Sandman6z/BalanceCar-DualFOC/README.md

# 桌面双轮平衡车

更新：2026-11-02。当前方案仅维护下面四份主文档，每个分类一个文件夹，不再使用docs/project/hardware等多层目录，也不维护多份快照、待办和决策表。

| 分类 | 主文档 | 内容 |
| --- | --- | --- |
| 整机整体 | [整机方案](整机整体/整机方案.md) | 全部选型状态、需求、运行规则和下一步工作 |
| 硬件 | [硬件方案](硬件/硬件方案.md) | STM32 BGA候选、驱动、供电、充电保护、回生、外围、接口及来源 |
| 软件 | [软件方案](软件/软件方案.md) | 双FOC、LVGL、交互、恢复逻辑、参数提案和验证 |
| 结构 | [结构方案](结构/结构方案.md) | 3D打印底座、电池/电机/板卡安装、标定与待补尺寸 |

当前：用户于2026-10-29暂定STM32G431RBI6（170 MHz、128 KB Flash、32 KB SRAM、UFBGA64），按双FOC＋精简LVGL推进；已完成最小工程链接、引脚数据库核查及GUI/数学ARM仿真；画板前仍需完善实际驱动与确认采样电气条件。其他型号保留为历史比较。电源/驱动桌面复核另发现LDO热耗散、扩展Buck低压输入、3PWM故障禁能及制动启动等问题，修改提案与未通过项见硬件方案。FUET-8530-3.6V已选；电池为3节普通平头18650，寿命不作选型要求。

2026-11-02按用户要求简化驱动保护：两DRV共用一个nFAULT输入，取消外部AND门/D触发器必选要求，保留内部保护、独立ENABLE和软件故障锁定。接线提案见硬件第11.1节；旧资源验证文件尚未更新，未完成原理图或实测。

主控、硬件电路和参数仍处于设计阶段。已有[MCU资源验证工程](软件/软件方案.md#7-验证与开发环境)，尚无完整运行固件、新版完整原理图、PCB或结构CAD，未完成样机验证。工程建议不等同用户定案，历史报价不等同实时库存/成交价。

OneDrive当前入口：`C:\Users\boe\OneDrive\平衡车`。

OneDrive的`硬件/历史资料.zip`保存整理前的全部模块化文档，以及原OneDrive项目的Word、HTML、脚本、网表和渲染物；该包仅供追溯，不作为当前接线依据。历史包只随OneDrive保存，不向GitHub重复上传旧资料；原模块化文档可从Git提交`0004bbb`及此前历史恢复。

今后直接修改对应主文档，并在该分类目录存放原理图、源码或结构文件；不再新增重复的“当前方案/最新版/快照”副本。许可证见[LICENSE](LICENSE)。
