Sandman6z/BalanceCar-DualFOC/硬件/硬件方案.md

# 硬件方案

更新：2026-11-02。所有已确认范围见[整机方案](../整机整体/整机方案.md)。本页合并原硬件选型、电源预算、接口、充电、保护、蜂鸣器和电路调查；只保留一套当前描述。工程候选未等同用户选定；原理图、PCB、完整BOM与样机验证尚未完成。

## 1. MCU与采购

当前主控依据：[G431官方手册](https://www.st.com/resource/en/datasheet/stm32g431rb.pdf)、[用户指定立创商品](https://item.szlcsc.com/778058.html)。

仅选STM32、BGA，球数不限，需同时运行双FOC、姿态/平衡、LVGL、USB和外围。用户2026-10-29暂定STM32G431RBI6：170 MHz M4F、128 KB Flash、32 KB SRAM（22 KB SRAM＋10 KB CCM）、UFBGA64、5×5 mm、0.5 mm球距。按精简LVGL推进，选择型号不代表资源验证通过；其他型号保留历史比较，GD32已排除。

| 型号 | 资源与封装 | 本轮采购记录/判断 |
| --- | --- | --- |
| G473VEH6 | 170 MHz M4F，512 KB Flash/128 KB RAM，TFBGA100、8×8 mm、0.8 mm球距 | 得捷美国页显示2088颗；1颗US$12.06、10颗US$9.385/颗；非中国含税到手价，国内低价散料未核实 |
| G491REI6 | 170 MHz M4F，512 KB/112 KB，UFBGA64、5×5 mm、0.5 mm球距 | 得捷中国页显示1613颗，含13%税1颗78.90元、10颗61.049元/颗，运费另计；IO仍需精算 |
| G474VEH6 | 170 MHz M4F，512 KB/128 KB，TFBGA100、0.8 mm；增加HRTIM | 得捷页显示库存0、补货日期未知；1颗US$11.66为缺货报价；不能由一渠道缺货推断全市场无货 |
| G431RBI6，当前暂定 | 128 KB/32 KB，UFBGA64、0.5 mm | 立创图片页24.06元起/194颗与索引25.78元起/200颗不一致，数量档未知；不据此宣称1颗价。用户2026-10-29暂定；最小链接与球位核查通过；电气与实时性能待实测 |

以上为2026-10-28获取的页面/索引记录，价格库存时点不统一，不是实时成交保证。市场聚合价和贴片专用库存不能替代可单独购买的小批散料。0.8 mm通常更利于扇出，但100球四层能否布通仍需按板厂工艺验证。

当前按G431的TIM1/TIM8与两个ADC评估双电机方案；4路电流输入须核对有效采样窗口及错峰触发。不能只看内存或定时器数量：必须完成准确BGA球位、AF复用、ADC触发、DMA、中断执行时间和Flash/RAM编译评估。容量预算统一见软件方案，不再设置“必须256 KB RAM”的排除门槛。

## 2. 电机驱动、电流采样与PCB

- DRV8323SRTAR×2，SPI、无集成系统Buck、内置CSA，左右各6颗外置N-MOS。每电机3PWM、双低侧电阻，共4个ADC输入，第三相按电流和重建。
- ENABLE上电/复位默认禁能；两颗nFAULT开漏并接，共用一个MCU故障输入。取消外部AND门和D触发器必选要求，按第11.1节简化方案停双电机；不能只将PWM拉低当全部MOS关闭，故障解除不自动恢复力矩。驱动寄存器配置/回读、CSA零偏校准是启动检查。
- 电荷泵、驱动供电/VM去耦、SDO上拉、PWM模式和未用CSA通道/LS_REF按DRV8323手册设计，不能简单把第三相所有检测节点接地。
- CSD17577Q3A×12为MOS电气候选：30 V等级、实际4.5/10 V栅压导通参数及Qg需核对；30 V是否够由最坏钳位和VDS尖峰决定，成本未证实最优。栅阻4.7 Ω仅作预留起点，IDRIVE由波形调整。
- 采样提案：每电机2×10 mΩ、1%、Kelvin/四端、2512级1 W起评估，CSA增益20。0.2 V/A；若有效双向余量假设±1 V，约±5 A测量范围，扣除零偏/摆幅/瞬态后再定；不是电机安全电流。
- 5 A情景下I²R=0.25 W，仍需脉冲与PCB热降额。未定电机不得用相电流范围代替电池/BMS电流，也不得移植航模高KV 2204参数。
- 主板优先四层、连续地参考，功率回路短、局部去耦贴桥；大电流回流不穿过CSA/ADC/IMU参考。SWD、NRST、电源与触发测试点保留。封装、EPAD、栅回路和Kelvin线按原厂要求。

## 3. 电源路径与软开关

以下是落实已定行为的功能提案，不是可直接接线图。保护芯片共口/分口、MOS方向及地关系按准确后缀完整资料落实。

```text
3S电芯 → CW1244保护输出 PACK_PROTECTED
  ├─ 核心电池锁存开关 → TPS563201 → 5V_BAT → 电源MUX
  └─ 电机背靠背开关 → VMOTOR → 双DRV8323/功率桥
                          ├─ 共用制动电阻＋低侧MOS
                          └─ 独立5V_BRAKE → 比较器/必要缓冲
USB VBUS → ESD/总输入限流/防反灌
  ├─ 电源MUX → 5V_SYS → 主板LDO/外围/ESP32扩展
  └─ IP2326 → 受保护充电端 → 电池
```

- 核心电池保持与电机运行开关分开控制，才能在USB下关运行电源而保留OLED/VCOM。USB事件本身不生成电机授权。
- TPS2113A的DRB封装为5 V级MUX候选，不接3S原电池；按实际后缀、电流、切换跌落及反灌核算。核心优先USB，电池保持已生效时拔USB转电池待机。
- 运行开关采用背靠背高侧MOS方向，开通时允许必要双向回生、关闭时隔离；启动涌流/斜率另算，不仅用Buck EN代替总开关。
- 电源键基础锁存＋MCU计时方向：按下可临时唤醒核心检测长按，未满2秒不显示用户开机、不接电机电源；松开撤销临时供电。长按成立才进入正常启动。短按用户可见行为仍为无动作。
- USB下长按关机撤销运行供电/电池保持；菜单重开运行供电同时恢复电池核心保持。MCU复位清除力矩许可，供电锁存可独立保持以显示复位原因。
- 不做8秒硬件强关，不增专用强关芯片。保留BMS及基础按键电路静态消耗，不宣称关机电流绝对为零。
- 关机先撤销力矩并禁能，再断运行电源；制动回路及控制供电始终位于电机母线同侧。USB、调试器、充电地不能旁路低侧BMS；B−/P−/C−不得随意短接。

## 4. 主板、扩展板与负载预算

主板TPS563201DDCR输出5 V，TPS562201DDCR备选，再由LDO生成3V3_MAIN。ESP32扩展板原拟用另一颗TPS563201将主板5 V降为3V3_ESP；其4.5 V输入下限在MUX/线损后缺少余量，保留降压架构但器件待重选，两路3.3 V不并联。扩展板插上随5V_SYS供电，不增加独立GPIO控制电源；其防插拔保护由用户负责，主板仍核查反灌与插入瞬态。

ME6211C33M5G-N与ME6217C33M5G均保留为待核查候选。准确商品手册缺少SOT23-5的功耗/热阻数据，不能仅凭旧家族资料300 mW排除；也不能凭标称500/800 mA宣布持续带载已通过。P≈(5−3.3)I，100/150/200/300 mA分别约0.17/0.255/0.34/0.51 W；不能用“标称500 mA”判定SOT23热能力。对应-N完整资料、稳定电容及实际PCB热阻需确认。若不够，先比较更好散热的LDO封装；改变稳压结构另列工程方案。

| 负载域 | 需要核对 |
| --- | --- |
| 3.3 V MCU | 按当前G431RBI6、频率和外设重算；旧G431的70 mA预算不能直接继承 |
| AS5047P×2 | 建议3.3 V模式，正常运行手册Max 15 mA/颗；OTP供电条件单列，不当正常负载 |
| IMU | 工作模式、3.3 V电流与中断；0.55 mA等典型条件不能当本车最大值 |
| OLED | 准确模块供电/上拉/分辨率/全亮电流；旧50 mA仅占位 |
| LED/上拉/ADC分压 | 蓝绿灯提案约1 mA/颗，按VF与亮度定阻值；其他逻辑逐项统计 |
| FUET蜂鸣器 | 若取3.3 V需计入线圈峰值、鸣叫平均电流及LDO温升 |
| 5 V | LDO输入、WS2812、OLED若取5 V、扩展Buck输入功率与损耗 |

旧166 mA/200 mA、5 V约0.878 A均为混合条件情景，不是新MCU下最坏电流。ESP32供电至少0.5 A能力的原厂建议也不是最大负载保证。Buck电感/输出电容按输入下限、饱和、负载峰值、偏压降容和纹波重算。

## 5. 充电、保护与均衡

电芯已明确普通平头18650，3S、满电12.6 V，循环寿命不作选型要求；不额外要求用户现在提供具体型号。正式限流/充放电前仍核对实际电芯，不能由外形推定安全电流。2500 mAh/节、约27 Wh若用于预算必须标占位，不显示为真实容量；三串容量mAh不相加。总压不保证弱单节状态。

IP2326标准版已定，5 V输入升压给3S充电，EN硬件默认低、MCU控制；3S配置和外围按V1.11，CON_SEL经1 kΩ接地等接法需与准确版本复核。不能混用IP2326_8V8。D+/D−用于MCU原生USB，不直接并接充电芯片DP/DM；首版不做PD/QC申请。

0.5 A电池侧是功率核算起点，不是批准的设置。12.6×0.5=6.3 W，按85%效率示例需USB约1.48 A，另加核心/扩展消耗；普通电脑500 mA输入不能许诺该充电电流。输入限流同时覆盖核心和充电分支；源能力未验证则拒绝启充并显示原因。

充电完成优先使用可靠状态输出并结合电池电压、超时和故障分类；IP2326资料终止电流200～300 mA及系统并联负载影响需实测。输入掉电、超时、过温与EN关闭均不当充满。USB核心可单独启动，但BMS欠压恢复/低电芯充电仍按实际电路处理，不宣称已经解决。

CW1244ALBS负责独立逐节保护、过流/短路/温度及被动均衡，不依赖MCU；IP2326的23/24脚仍悬空，其2S均衡不用于3S。当前公开简版资料不足以冻结准确ALBS后缀的保护MOS、采样、NTC、均衡阻值/电流、延时和恢复接线。这是原理图定稿前需补齐的资料项，不编造参数或抄其他BMS。

电池温度与功率区各留MCU NTC检测方向，BMS温度电路独立核对；10 kΩ/B3950是候选方向，不能未经分析共接两个检测输入。保留逐节测试点、配组核查、断线/短路诊断。BM3451SMDC-T28A、IP3255AAQ已排除；CN3303、BQ77915、S8254/HY2213等仅为历史对照。

## 6. 回生与过压

电机共用母线→制动电阻→低侧N-MOS→同侧功率地。TLV3012B（集成基准、推挽）为优先电气候选；TLV3201＋外部基准为对照。按实际Qg/米勒平台/源灌电流核对直驱，能力不足加缓冲，不默认LM5109。MCU仅监测，不作为硬件耗能动作依赖。

TPS70950从VMOTOR产生独立5V_BRAKE是供电候选，仅供比较器和小驱动；输入范围、散热、基准启动和回生供电建立时间都需核算。芯片可从母线取能不等于断电转轮时及时建立控制。

| 工程起点 | 值与限制 |
| --- | --- |
| 迟滞目标 | 旧13.4/13.0 V提案撤回；改评估约13.8 V导通、13.4 V释放，误差/负载边界见第11节，仍不是投板定案 |
| 制动电阻 | 用户已选定RESI TPAN0263F6R80K9，6.8 Ω±1%、50 W、TO-263，立创C38486200；13.8 V完全接通约2.03 A/28.01 W，散热与脉冲工况仍待验证，见第18节 |
| 制动MOS | 可先以CSD17577Q3A核算驱动负载，未定；需实际栅压导通与开关波形验证 |
| 母线电容 | 470 µF/35 V低ESR＋各桥局部陶瓷作为布局额度；并非已证实足够 |

电阻额定功率受安装/散热条件限制，须看脉冲能量及重复热耗散，远离电芯、IMU和塑料。TVS或母线电容不能代替持续回生耗能。按I≈V/R、P≈V²/R、E=∫Pdt、ΔV≈IΔt/C核算；控制供电上电时间须取最坏情况，不能只取比较器传播延时。

迟滞提案：VMOTOR经Rt接IN+，IN+经Rb接地、经Rf接比较器输出形成正反馈，IN−接基准。理想公式V_on=Vref(1+Rt/Rb+Rt/Rf)−VOL·Rt/Rf，V_off以VOH代替VOL；实际加入内部迟滞、误差与负载。ADC分压独立，避免采样扰动比较器门限。验证满电、BMS断开、MCU复位、控制电源异常、双电机同时回生和外力转轮。

## 7. 外围与板间接口

- AS5047P×2：SPI共享独立CS、奇偶校验，建议3.3 V模式，VDD/VDD3V3及去耦按原厂；5 V模式逻辑门限不能默认兼容3.3 V。
- ICM-42670-P：3.3 V逻辑、SPI＋INT，按原厂去耦，远离功率磁场、蜂鸣器及机械应力。
- SSD1315：0.96英寸I²C模块，LVGL驱动层适配；核查实际分辨率、引脚、供电、上拉及初始化，不直接套SSD1306模块参数。
- FUET-8530-3.6V：已选无源电磁，手册额定3.6 Vo-p、范围2.5～4.5 Vo-p、2700 Hz/50%方波条件、电流MAX 100 mA、16±3 Ω。这些不保证本车3.3 V声压或开关瞬时电流。建议3.3 V＋低侧逻辑级MOS，默认关闭、去耦/感性保护按厂家与波形验证，不接MCU直驱或5 V脉冲。表列8.5×8.5×3.0 mm与渠道高度差异需核实，焊盘不按同名8530互换。
- WS2812×4：主板5 V，SN74AHCT1G125电平转换候选，逐颗去耦/首颗串阻/OE默认态与掉电反灌核查；软件限亮不代替硬件峰值预算。
- 蓝绿0603各1：用途见软件，GPIO与阻值未冻；3.3 V蓝灯压差不足时再评估5 V开关驱动。
- Type-C：USB2.0受电设备，CC1/CC2各自5.1 kΩ、接口侧低电容ESD，VBUS总限流/反灌保护；CC下拉不等于允许取3 A。
- 扩展侧HC-PBB08-2-16-M-H1.0-G1-R-P-04已明确；主板母座候选HC-PBB08-2-16-F-H4.0-G1-R-P-04，准确配对/合高/脚号/镀层与封装待核查，不能仅将H值相加。16接点提案5 V×3、GND×5、UART×2、预留×6，按触点额定值和镜像脚号调整。UART掉电反灌/热插拔尚未验证。

## 8. 功能信号预算

| 功能 | 数量 |
| --- | ---: |
| 双电机3PWM | 6 |
| 四路相电流ADC | 4 |
| 两编码器SPI含两CS | 5 |
| 两驱动SPI含两CS | 5 |
| IMU SPI＋INT | 5 |
| OLED I²C | 2 |
| WS2812数据、蜂鸣器PWM、两普通LED | 4 |
| 母线ADC | 1 |
| K1/K2 | 2 |
| ESP32 UART | 2 |
| USB D+/D− | 2 |
| CHG_EN | 1 |
| 上述保守小计 | 39 |

另加SWD、NRST、驱动ENABLE/nFAULT、两路温度ADC、VBUS、充电状态、电源键/核心保持/运行开关、晶振与必要故障联动，39不是最终总数。IMU与驱动共享SPI可减3脚，但模式切换、开漏MISO上拉及调度必须验证。按当前G431RBI6重新画完整球位表，不使用旧G431预算宣布够用；不删调试或保护接口凑脚。

## 9. 依据与采购口径

以下保留当前方案的主要原厂/准确型号证据；完整历史调查与渠道截图线索在历史资料包及Git历史，旧报价不当实时价格。原厂典型应用/EVM/商品采用都不等同本车验证。

- [G473手册](https://www.st.com/resource/en/datasheet/stm32g473ve.pdf)、[准确型号封装](https://estore.st.com/en/stm32g473veh6-cpn.html)、[得捷报价](https://www.digikey.com/en/products/detail/stmicroelectronics/STM32G473VEH6/12337611)。
- [G491手册](https://www.st.com/resource/en/datasheet/stm32g491re.pdf)、[得捷中国报价](https://www.digikey.cn/zh/products/detail/stmicroelectronics/STM32G491REI6/13592618)、[G474得捷](https://www.digikey.com/en/products/detail/stmicroelectronics/STM32G474VEH6/10326782)。
- [DRV8323手册](https://www.ti.com/lit/ds/symlink/drv8323.pdf)、[评估板](https://www.ti.com/tool/BOOSTXL-DRV8323RS)、[ST最小系统AN5093](https://www.st.com/resource/en/application_note/an5093-getting-started-with-stm32g4-series--hardware-development-boards-stmicroelectronics.pdf)。带R版Buck/原板采样不可整套照抄。
- [MOS候选](https://www.ti.com/lit/ds/symlink/csd17577q3a.pdf)、[TPS563201](https://www.ti.com/lit/ds/symlink/tps563201.pdf)、[ME6211家族资料](https://datasheet.lcsc.com/datasheet/pdf/d15331d096a848ac81a26b001a32d4e3.pdf?productCode=C82942)。
- [TPS2113A](https://www.ti.com/lit/gpn/TPS2113A)、[TPS709](https://www.ti.com/product/TPS70950)、[TLV3012B](https://www.ti.com/lit/gpn/TLV3012B)、[TLV3201](https://www.ti.com/lit/ds/symlink/tlv3201.pdf)、[迟滞参考](https://www.ti.com/tool/CIRCUIT060078)。
- [IP2326 V1.11](https://m5stack-doc.oss-cn-shenzhen.aliyuncs.com/1132/IP2326.pdf)、[Tab5官方资料](https://docs.m5stack.com/en/core/Tab5)、[CW1244简版资料](https://uploadcdn.oneyac.com/attachments/files/brand_pdf/cellwise/11/66/Cellwise-CW1244_V1.5.pdf)。Tab5为2S参考，不证明本车3S接法；CW简版不足以冻结准确后缀外围。
- [AS5047P手册](https://www.infineon.com/assets/row/public/documents/30/49/infineon-as5047p-datasheet-en.pdf)、[ICM-42670-P资料](https://d17t6iyxenbwp1.cloudfront.net/s3fs-public/2026-05/ds-000451-icm-42670-p-datasheet.pdf)、[ESP32模组手册](https://documentation.espressif.com/esp32-s3-wroom-1_wroom-1u_datasheet_en.pdf)。
- [FUET准确型号承认书](https://atta.szlcsc.com/upload/public/pdf/source/20260910/B8B8C01008C0ED8239F313DAC3587B74.pdf)、[FUET零售入口](https://item.szlcsc.com/410561.html)、[SN74AHCT1G125](https://www.ti.com/product/SN74AHCT1G125)。
- [BTB公座图](https://www.hctldz.com/static/upload/2026/01/29/202601298345.pdf)、[BTB母座系列图](https://datasheet.lcsc.com/datasheet/pdf/1f2bc63b424e11ba595813a8850d68e5.pdf?productCode=C41421151)。

## 10. G431RBI6验证结果（2026-10-30）

结论：保留当前型号继续实现。准确UFBGA64封装的52个I/O类球位（含NRST）已按本机CubeMX官方数据库逐项检查球号、唯一性及AF/ADC可用性。51个功能IO全部使用，没有空闲；这是可行但紧凑的方案，不是完整原理图电气检查通过。

完整分配见[引脚CSV](../软件/MCU验证/pinout.csv)，自动检查见[verify.py](../软件/MCU验证/verify.py)。本轮实际采用以下安排：

| 项目 | 当前验证方向 |
| --- | --- |
| 时钟 | HSI16→PLL 170 MHz；USB采用HSI48＋CRS跟踪USB SOF；不用HSE/LSE，PF0用于电池电压ADC、PF1原作PWM_ARM_CLOCK；2026-11-02改为直接INL许可提案，见11.1 |
| 双PWM | PA8/PA9/PA10=TIM1 CH1～3；PC6/PC7/PC8=TIM8 CH1～3；中心对齐同步运行 |
| 电流 | ADC1：PA0/IN1为左A，PA2/IN3为右A；ADC2：PA1/IN2为左B，PA6/IN3为右B |
| 慢速模拟量 | PA3=运行母线、PF0=电池、PB0=电池NTC、PB2=功率NTC；不能直接接电池电压，需独立分压及保护 |
| SPI | SPI1独占两编码器；SPI3由IMU与两DRV共享，独立CS，切换模式/速率和调度仍需实现 |
| 故障 | 旧资源验证用PB12/TIM1_BKIN＋PD2/TIM8_BKIN和外部锁存提案；2026-11-02用户确定简化为两DRV共用一根nFAULT至一个MCU输入，建议保留PB12（EXTI兼TIM1_BKIN）、释放PD2。取消外部锁存，完整接线见11.1；原CSV/探针尚未随本次文档更新 |
| 启动脚 | PB8/BOOT0用于CHG_EN，必须硬件下拉保持默认禁充；I²C1改为PA15/PB9，避免BOOT0受I²C上拉影响；保留SWD，释放完整JTAG |
| 指示灯 | 蓝灯由VBUS硬件驱动，绿灯使用PB7 |
| 充电状态 | PC2改为ADC1_IN8测VBUS电压，PC3采LED状态并适配电平；BAT_STAT不再采集，它只表示涓流/恒流阶段，非充满/保护信号。充满与隐藏BMS停充仍缺少可靠区分依据，不能直接验收 |

DMA规划更新为9个通道（G431共有12个），第9个供ADC1慢速规则组含VBUS检测；见pincheck.json。电流注入组仍用中断读取，不依赖ADC DMA。通道数量核查不等同总线/中断优先级和实时调度验证。

采样计算：TIM1 ARR=4250、170 MHz中心对齐为20 kHz；TIM1 TRGO使能边沿经TIM8 ITR0启动同步，TIM1 TRGO2/OC4REF独立触发ADC。两ADC注入同时模式各2秩，先同时采左A/B、再同时采右A/B。ADC同步时钟42.5 MHz，24.5周期采样＋12.5周期转换，双秩理想耗时约1.741 µs。两PWM同相、各相占空比上限92%时，共同低侧窗口理想宽4 µs；触发在峰值前1 µs，暂按边沿稳定保护1 µs评估。上述保护时间是设计假设，须用实际MOS、驱动、CSA、分压/RC和布板波形验证；不可直接作为已证明采样有效的结论。

ADC事件周期50 µs，电流计算隔次执行为每电机10 kHz；包含双FOC的最长ADC ISR必须小于50 µs，初步目标≤30 µs。与仅按100 µs电流周期留60 µs预算的旧表述不同，不能漏掉中间一次ADC事件的期限。ADC慢速规则组、同步误差与极端占空比同样待检查。

依据：[ST RM0440](https://www.st.com/resource/en/reference_manual/rm0440-stm32g4-series-advanced-armbased-32bit-mcus-stmicroelectronics.pdf)，本机Rev 9的ADC触发章节及表267（TIM8 ITR0=TIM1 TRGO）；[G431手册](https://www.st.com/resource/en/datasheet/stm32g431rb.pdf)。本轮CubeMX手工IOC导入/生成未完整保留外设配置，未作为通过证据，也不交付该不完整IOC；以数据库逐项检查、手工HAL配置编译和明确的实测待办为依据。

## 11. 其余硬件桌面复核（2026-10-30）

本轮获取并核对驱动、MOS、Buck/MUX/LDO、比较器、编码器、IMU、ESP32、蜂鸣器及逻辑器件原厂资料。来源版本/文件SHA256见[资料索引](资料索引.json)。可复现计算与理想逻辑检查：[verify_hardware.py](verify_hardware.py)，运行`python 硬件/verify_hardware.py`，结果为[验证结果.json](验证结果.json)。本轮没有实物、正式网表或SPICE电路，以下“通过”仅限指定计算/逻辑范围。

### 11.1 双DRV共用故障输入，取消外部逻辑锁存（2026-11-02）

用户明确要求简化，首版两颗DRV8323S共用一个nFAULT输入；不再把外部AND门、D触发器、独立硬件重ARM及母线比较器列为必选。此前外部锁存方案撤回为当前实施要求，旧布尔验证仅证明旧模型，不能当简化方案已验证。

防止同一半桥上下MOS同时导通，主要依靠DRV8323的TDRIVE栅极握手、自动死区及寄生误导通抑制；仍需正确选择IDRIVE/TDRIVE、栅阻、MOS和布板，并检查VGS波形。nFAULT是故障报告，不能承诺靠一根线保证所有故障都不烧管。

接线与动作的简化基线：

| 项目 | 当前安排 |
| --- | --- |
| nFAULT | 两颗开漏输出并接为DRV_FAULT_N，一颗上拉到3V3_MAIN，共用一个MCU输入；建议PB12兼EXTI/TIM1_BKIN，AOE关闭。不把输出接到各自独立电源上拉后再并联 |
| 两颗ENABLE | 保留PB13/PB14独立控制和硬件下拉，上电/复位默认禁能 |
| 六个INH | 接原六路PWM并设下拉；配置完成前强制为低 |
| 六个INL | 提案由PF1直接作为共用INL许可控制，两组近DRV设下拉，默认低；PF1不再作触发器时钟。六输入漏电、内部下拉和总电容须核对，未验证GPIO扇出 |
| 内部保护 | 设置并回读3PWM、锁存过流模式OCP_MODE=00b及CSA参数；保留栅极故障、欠压等保护，实际门限随MOS/电机确定 |
| 故障处理 | 共用故障线触发快速中断，先拉低INL许可、强制六PWM低并撤销双ENABLE，停止两电机；随后处理诊断。SPI详细故障在驱动可通信时读取，必要时保持INL/PWM低重新唤醒读取；ENABLE复位可能清故障，不承诺保留原始全部状态 |
| 恢复 | 驱动相关故障由软件锁定，人工请求且检查通过后恢复；不因nFAULT回高自动启动。摔倒/传感器故障仍遵守原有限自动恢复规则 |

用户确认的是简化架构；PB12单输入和PF1直控INL是接线提案，不是已投板或验证通过。PD2不再需要用于第二个Break，可保留备用；BAT_STAT不因此自动恢复采集。原资源CSV、代码与验证结果保留历史版本，重新落实引脚时再更新，不宣称已有完整新固件。

必须保留的时序：DRV默认6PWM，模式配置前INH与INL均须为低；按手册唤醒并配置、回读3PWM后，才能准备PWM和拉高INL许可。正常停机/故障快速路径使INH、INL都低，遵守ENABLE休眠时序，不能仅用Break将3PWM拉低代替桥禁能。Break只作用于所接定时器，双电机关闭依靠中断操作，首版接受该软件联动方式，不宣称是独立于MCU的双桥硬件关断。

验收聚焦上电/复位不误导通、上下管VGS无危险重叠、任一DRV故障能停双电机、故障恢复不自行启动，以及停机/重新初始化正确。尚无原理图、样机或上述实测。高阻后绕组仍可能通过体二极管向母线回生，泄放保护继续单独设计。

依据：[DRV8323原厂手册](https://www.ti.com/lit/ds/symlink/drv8323.pdf)，第8.3.1.1、8.3.1.4.2、8.4.1.1节及相关保护寄存器。

### 11.2 稳压、总负载与USB

已纠正原审查结论：旧ME6211家族V14泛称SOT23功耗300 mW，但用户提供的ME6211C33M5G-N准确商品页对应V22手册，第5页300 mW/410°C/W仅列SOT23-3，缺少M5/SOT23-5条目；不能据此把M5-N直接判为不足。ME6217C33M5G商品页对应V02，第2页1 W只针对SOT89-5，也缺少SOT23-5热参数。两者标称输出电流500/800 mA均覆盖当前约300 mA工程额度，持续温升仍未证明；保留两颗候选，不因这份缺项资料直接决定改DC/DC。

本轮3.3 V工程分配为MCU100 mA、编码器30 mA、IMU5 mA、OLED50 mA、杂项15 mA、两DRV VREF合计6 mA，基础206 mA；加鸣叫平均100 mA为306 mA，LDO约0.520 W。蜂鸣器线圈最小13 Ω在3.3 V下的纯电阻峰值上界约254 mA，总瞬时分配约460 mA；这不是实际线圈波形，不能当持续平均电流。所有分配含占位值，尤其OLED、MCU和IMU不是已测最大值。

替代候选可比较TLV75733PDYDR（带散热焊盘SOT23）/TLV75733PDRVR（WSON），保持已定LDO架构。家族手册支持1 A、VIN 1.45～5.5 V；DYD/DRV的JEDEC热阻分别约92.5/100.2°C/W，不能把EVM的DYD 60.3°C/W套到普通DBV。0.520 W、环境50°C时，按100.2°C/W情景估Tj约102°C；最坏输入/输出误差、板内环境60°C及0.6 W以上热耗散会接近限值。需要焊盘/铜皮设计和实测，未以该估算冻结型号或价格。

主板TPS563201在3S→5 V的输入范围可继续；5 V原厂LC建议L=3.3～4.7 µH、有效C=20～68 µF。54.9k/10k＋0.768 V参考的标称输出约4.984 V；12.6 V、3.3 µH、580 kHz情景电感纹波约1.576 A峰峰值。按实际负载峰值和电流限制选饱和/温升能力，不以3 A输出标称选一颗仅3 A饱和的电感。

扩展板TPS563201不能直接判通过：USB端4.75 V，经MUX 1.5 A×150 mΩ及额外0.1 V线/保护压降，仅剩4.425 V，低于4.5 V推荐输入下限。保留5→3.3 V降压架构，重新比较低输入下限Buck；TPS62133的3～17 V、3 A仅作为电气对照候选，成本/采购及外围尚未冻结。

TPS2113A必须使用所评估的DRB封装，不能混用PW的1.25 A档；DRB可调到2 A，但限流误差与热态压降必须核查。例如手册RILIM=400 Ω时标称1.25 A、范围0.95～1.56 A，不能把标称值当保证输出。两路输入只接5 V级电源，禁止3S直接进入。主电池/USB切换压降、保持电容、逆灌和限流未通过台架验证。

按本轮分配、4颗WS2812各60 mA占位、ESP32 3.3 V/0.5 A及85%效率，5 V域约0.949 A；0.5 A电池充电在12.6 V另需USB约1.482 A，合计约2.432 A。若USB4.75 V、效率80%、电池充电上偏至0.55 A且ESP32按1 A情景，合计约3.253 A，连3 A源也不够。1.5 A源在核心占1 A时，只剩约0.169 A电池充电功率。不能将“5 V/3 A”当任何功能组合都可同时打开的保证。

普通电脑USB不能承诺同时带ESP32、全亮灯和充电。USB总限流要在充电与核心分支之前，MUX只限制核心支路；IP2326输入欠压环也不等于USB源授权/总电流限额。扩展板仍按用户要求直接取5V_SYS，不新增独立主控电源开关，因此必须明确扩展固件低功耗启动约定，并核查枚举前负载、插入浪涌和低能力源场景；本项仍未通过。

### 11.3 充电、保护与状态可观测性

IP2326 V1.11确认CON_SEL经1k到地选3S、VSET悬空对应12.6 V、RISET=180k对应0.5 A（电池端，手册±10%）；0.5 A仍只是起算值，需按实际电芯批准。DP/DM不接USB数据线：芯片在3S电压升高后会尝试申请7/9 V，不能让它与MCU原生USB共线；首版不使用快充协商，具体未用引脚接法仍需核对。

NTC与状态必须单独处理：资料示例100k/B4100并82k属于特定保护窗口，文中约45°C减流、55°C停充；不能把它当任意18650都合适，也不能把通用10k NTC直接代入。MCU/BMS/充电芯片的独立激励不能共接一个NTC节点；按实际电芯允许温度重新设计硬件窗口，MCU暂定10～40°C不能替代硬件窗口验证。

LED亮/灭/闪可描述充电、停止和异常；BAT_STAT仅描述涓流/恒流，本轮不再采集。没有可靠BMS状态时，LED灭＋总压正常仍不能严格证明正常充满：保护MOS断开、弱单节先过压或负载断开可能造成歧义。未补可信的BMS状态/单节观察或等效判据前，界面应显示“充电已停止/原因待确认”，不把所有停充显示成“已充满”；整机“正常充满可正确显示”验收项仍未通过。

CW1244公开V1.5只有简版功能/框图：ALBS可解析为A功能版本、L锂离子、B参数型、S封装型，但B型准确阈值/延迟和完整接线没有得到证明。不得用家族阈值范围代替B型配置，不得抄其他后缀补齐外围。三串均衡、过温/断线、保护MOS与恢复路径继续作为定稿阻塞项；IP2326的23/24脚仍不作3S均衡使用。

### 11.4 驱动、采样与共用SPI

10 mΩ×20=0.2 V/A可继续作为测量提案；5 A时每个电阻0.25 W。CSA增益约±3%、分流电阻±1%叠加约±4.03%，4 mV输入零偏折算0.4 A，必须校准，电流正负号也需按接线核对。DRV手册增益20、0.5 V阶跃到±1%的600 ns是条件/典型值，不是包括MOS换向、RC和ADC采样的总最坏时间；另加100 Ω/1 nF滤波本身到1%就约0.461 µs。因此第10节的1 µs边沿保护只是待实测假设，不能用“600 ns<1 µs”宣告4 µs窗口已保证。

特别纠正：SEN_LVL最低0.25 V在SP输入上的保护，10 mΩ对应25 A；默认1 V约100 A，均与CSA增益20无关。它不是5 A保护。VDS保护随MOS导通电阻、温度和门限误差变化，也不能直接当精确5 A。实际电机/电芯未知前，保留软件限流、内部锁存过流保护与软件故障锁定、VDS/VSENSE保护，并补充可验证的过流门限与响应设计，禁止以测量范围代替保护阈值。

CSD17577Q3A手册10 V栅压RDS(on)最大约4.8 mΩ、4.5 V约6.4 mΩ，Qg(10 V)最大约35 nC；3颗高侧20 kHz的平均栅电荷电流约2.1 mA，低于DRV所列25 mA平均高侧能力，但仍需看低电池电压、温度、死区和IDRIVE。栅阻4.7 Ω不是最终值；30 V VDS尖峰及热设计未通过，35 A封装标称不能当本车相电流。

编码器SPI1保持Mode 1、170MHz/32=5.3125 MHz；AS5047P上限10 MHz，CS建立与帧间高电平均至少350 ns。两片按读命令＋后续返回帧估64时钟，加4段350 ns约13.45 µs，属于通信时长估算而非总控制执行时间；需处理流水返回、奇偶和ERRFL。

SPI3的DRV采用Mode 1并降到/128=1.328125 MHz，SDO先按2.2k上拉、50 pF总线电容情景，升至0.7VDD约132 ns；再加30 ns数据延迟及20 ns采样裕量，小于半周期376 ns。电容、IMU下拉驱动能力及实际波形仍需核查。IMU默认支持Mode 0/3，可先按默认模式配置，再通过DEVICE_CONFIG.SPI_MODE切到Mode 1/2（CS释放后生效），运行时选Mode 1；仍为四线SPI。TDK资料明确未选中时SDO高阻，电气结构允许共享，不代表不同设备帧/速率/片选的软件已实现。

### 11.5 再生制动不能提前判通过

TLV3012B除参考误差外还有输入失调、2～8 mV内部迟滞（6 mV典型）和温漂。旧13.4/13.0 V中心值余量不足，保守角落计算释放点可能低至约12.51 V，存在满电母线制动后不释放的情景，因此撤回旧中心值。

新提案采用Rt=100k、Rb=10k、Rf=1.5M（0.1%）与5 V输出假设，含6 mV典型迟滞时约13.778 V导通、13.378 V释放，即约13.8/13.4 V。脚本按参考额外±1%温漂、等效失调/CMRR±12mV、输出摆幅与电阻角落给出约13.24～14.29 V导通、12.86～13.92 V释放的保守设计包络；不是原厂联合最坏值保证。若按电池最高12.7 V设计，最低释放点仍有约0.16 V余量，但需连同充电最高电压和纹波重新确认。

TPS70950的VIN可到30 V，但EN推荐最大6.5 V，**不得把EN直接接VMOTOR**；手册允许EN悬空使能。其5 V版本启动最大1.5 ms是在手册指定负载/电容测试下；TLV3012B上电时间1.9 ms是典型值，不能只按数微秒传播延迟算启动。以VMOTOR起点6 V、回生2 A、5 ms未耗能、470 µF下偏20%的情景，电容模型升到约32.6 V，已经超过30 V MOS等级。这不是本车实测回生量，而是说明原容量/启动组合没有保证。

需要核查从VMOTOR自供电的全失电冷启动，以及核心有电时是否通过隔离供电提前保持制动控制就绪；另评估短脉冲钳位/更快启动/增加有效母线容量。比较器直接推35 nC级MOS也未通过，需核查负载下的反馈摆幅和栅充电，必要时加小逻辑缓冲。冷启动测试通过前，不冻结TPS70950＋TLV3012B组合。

10 Ω在13.8 V只吸约1.38 A、19 W；若回生源持续2 A，即使MOS全开也会趋向20 V而非13.8 V。实际电机、转速、转动惯量和BMS吸收状态未知，无法冻结阻值和脉冲能量。25 W额定依赖安装散热，TVS不得代替持续耗能。回生电阻、MOS、独立控制供电、母线电容与必要钳位均须在BMS断开、双电机同回生和外力转轮时验证。

### 11.6 外围与结构边界

AS5047P的3.3 V供电/逻辑可用，按3.3 V模式正确连接VDD与VDD3V3并去耦；两颗编码器按15 mA/颗计预算。磁场要求约35～70 mT；手册时序/精度参考磁铁为N35H、直径8 mm/厚3 mm，不等同用户磁铁选型。气隙、轴心和实际磁铁均未确定，结构需可调整并读DIAAGC诊断后验收。

ICM-42670-P的VDD/VDDIO均1.71～3.6 V，3.3 V兼容，SPI最高24 MHz；0.55 mA是特定低噪声典型条件，本轮5 mA仅工程额度。去耦、滤波延迟、数据就绪与陀螺/加速度量程须随实际控制确定。

FUET确认2700 Hz/50%、3.6 Vo-p额定、工作2.5～4.5 Vo-p、16±3 Ω及最大100 mA条件。继续3.3 V驱动方向，采用2.5/3.3 V栅压有导通保证的小MOS，不能因主桥MOS有4.5 V参数就直接拿来当3.3 V蜂鸣驱动。设计去耦、续流/钳位及默认关断后测声压和电流，不用额定平均值替代瞬时预算。

SN74AHCT1G125的4.5～5.5 V供电、VIH最小2 V支持3.3→5 V数据转换；零GPIO余量下/OE可硬件接低、A下拉使复位数据为低，不虚构独立OE控制脚。WS2812数量已定，准确版本的通道电流/时序仍待确定；四颗×60 mA是保守占位。OLED准确模块供电、I²C上拉和分辨率未知，尤其模块若把上拉接5 V，必须核对/修改而非默认直接接MCU。

VBAT/VMOTOR分压在MCU失电时仍可能注入3.3 V域；须核对掉电注入、必要的随3.3 V自动断开的检测开关和ADC源阻抗/RC，不能只凭大电阻宣称软关机无反灌。3S高侧MOS也不得直接由3.3 V GPIO拉栅，需相对源极的默认关断、栅压钳位及电平转换。核心锁存、MUX、运行开关目前没有正式网表，因此复位保持、USB优先和BMS地不被旁路仅是功能要求，尚未完成接线级验证。

BTB配对/合高、轮轴与磁铁几何、真实电芯/电机尺寸、3D打印散热和天线净空仍缺实物/CAD证据。本轮没有把这些未知项标为通过。

新增原厂依据：[TLV757P](https://www.ti.com/lit/ds/symlink/tlv757p.pdf)、[TPS62133](https://www.ti.com/lit/ds/symlink/tps62133.pdf)、[SN74LVC2G74](https://www.ti.com/lit/ds/symlink/sn74lvc2g74.pdf)、[SN74LVC1G11](https://www.ti.com/lit/ds/symlink/sn74lvc1g11.pdf)。其他原厂链接见第9节，资料PDF快照与校验清单放OneDrive硬件目录的“本轮核查资料.zip”；不向Git新增另一套Markdown报告。

## 12. 用户指定两颗LDO的准确资料复核

| 型号 | 商品对应手册 | 已确认 | 尚缺 |
| --- | --- | --- | --- |
| ME6211C33M5G-N | ME6211 V22，23页 | SOT23-5，3.3 V，标称500 mA；型号/引脚表明确包含该-N型号 | 第5页功耗/热阻表没有SOT23-5；300 mW/410°C/W不能从SOT23-3移用 |
| ME6217C33M5G | ME6217 V02，10页 | SOT23-5，3.3 V，系列标称800 mA；手册提示受封装功耗限制 | 第2页1 W明确仅SOT89-5，不适用于M5；缺M5热阻及允许耗散条件 |

5 V→3.3 V时，两颗的理论线性损耗都由(5−3.3)×I决定：100/150/200/300 mA分别约0.17/0.255/0.34/0.51 W；换成800 mA型号不会自动减少热量。300 mA是本项目尚未实测的工程预算，不能因为预算或缺失热参数就直接下“肯定不够”的结论。

后续可以继续采用LDO，条件是得到准确M5封装的热阻/允许功耗与测试板条件，并确认实际最大平均负载和板内环境温度。例：0.51 W、板内环境50°C，若设计结温目标125°C，需要实际有效热阻约≤147°C/W；该数值是设计反推条件，不是这两颗的已知热阻。准确结温上限、降额和散热条件仍按对应器件确认。DC/DC作为降低损耗的并行方案，不在用户本次询问中冻结架构。

原“ME6211不够”的表述过于确定，已撤回以300 mW直接排除ME6211C33M5G-N的依据。结论更新为：两颗电流标称可进入评估，M5热能力待确认，尚未通过持续负载验证。

依据：[ME6211C33M5G-N准确商品](https://item.szlcsc.com/84106.html)、[对应V22手册](https://atta.szlcsc.com/upload/public/pdf/source/20260922/E09393D8C99FBF717FF626B0B8E00241.pdf)；[ME6217C33M5G准确商品](https://item.szlcsc.com/421842.html)、[对应V02手册](https://atta.szlcsc.com/upload/public/pdf/source/20190910/C427602_D4B9162A2E9D9EF57C60010DFDECEF37.pdf)。已直接查看上述热参数表页面，确认缺项，不以文字提取错行作为结论。

## 13. ESP32电源与USB充电许可细化

### 13.1 扩展Buck的可核对候选

本轮核对TI的TPS62821/22/23家族手册：TPS62822为2 A，TPS62823为3 A，VIN推荐2.4～5.5 V，输出可调0.6～4 V，支持100%占空比；DLC为2×1.5 mm、8脚VQFN。它们可以进入5V_SYS→3.3V_ESP的候选池，重点评估4.0～4.4 V实际输入下的1 A瞬态情景，避免原TPS563201的4.5 V输入下限。100%占空比不具备升压能力，不能把“最低输入2.4 V”理解成此时仍输出3.3 V。

手册LC起点为0.47 µH，亦允许1 µH；输出典型2×10 µF或22 µF，至少5 µF有效容量，输入至少3 µF有效容量。ESP32方案先预留22～47 µF输出额度、靠近模组的去耦和必要输入储能；电容直流偏压降容、LC允许组合、感值偏差/饱和/DCR、供电软启动及插入浪涌需要按准确料号完成。EN可随供电固定使能，保持用户要求的“插上即随5V_SYS供电”，不增加主控独立电源开关；PG先保留测试点，不占新GPIO。

TPS62822/23尚未冻结：搜索服务本轮503，商城搜索返回反爬/无商品数据，未取得可核实的国内散料数量档价格/库存。不能据此宣称它们比TPS563201或TPS62133更便宜、更好买。当时AP63203原厂请求403，未用记忆参数把它加入已核验候选；后续重试成功，已核验的宽压候选及更新结论见第14节，渠道仍未核实。后续采购比较仍以小批总成本（含电感电容）为准，而非只看芯片预算价。

### 13.2 固定0.5 A充电的许可策略提案

当前ISET=180k的0.5 A是电池侧起算值，并有±10%资料误差，不是MCU可随意调节的USB输入电流。未增加可验证的电流调节硬件前，界面不提供虚构的“0.1/0.2/0.5 A软件设置”。

| USB与扩展状态 | 本轮策略提案 |
| --- | --- |
| 普通电脑USB、来源能力不明或确认仅1.5 A | 固定0.5 A电池充电禁止；保留符合输入能力的核心调试，扩展负载仍需约束 |
| 用户本次接入明确确认5 V/3 A、无扩展板并由用户确认 | 电池/温度/电机禁能及电源路径检查通过后，才接受本次手动启充请求 |
| 确认5 V/3 A、有扩展且安静模式已确认 | 无线关闭/限制，ESP32按3.3 V侧≤0.3 A工程包络核算；实际模式须测量通过，再允许手动启充 |
| 扩展存在但固件未响应、安静状态未知或无线重负载 | 不启充；不能把UART无响应自动解释为未插扩展 |
| 充电中电压跌落、温度/电池异常或扩展退出已验证模式 | 关CHG_EN并报原因，恢复后仍需人工请求，不自动反复启充 |

输入能力确认按每次USB接入会话处理，不复用上一次充电头设置；电压正常或USB未枚举都不能证明3 A能力。没有扩展存在检测脚时，“无扩展”必须来自用户明确确认，或后续另行验证的可靠检测，不能仅靠超时猜测。该策略没有改变扩展板直接供电的硬件要求。

按连接器VBUS 4.6 V、共同保护路径另降0.1 V、核心MUX按1.5 A×150 mΩ及支路线损0.1 V分配，IP2326输入取4.5 V、ESP32 Buck输入取4.175 V；再按效率80%、电池侧0.55 A上偏、主板基础206 mA（不含蜂鸣）、WS2812仍按4×60 mA瞬时占位、ESP32 3.3 V/0.3 A及另外0.1 A裕量，计算约2.78 A。ESP32若按1 A情景，约3.47 A，超过3 A。0.3 A是待实测的充电安静模式负载包络，不是把ESP32稳压器额定能力降到0.3 A；其电源仍需满足原厂至少0.5 A供电能力及瞬态要求。因此“3 A源”也必须配合已验证的扩展模式和负载边界，不能一律放行。充电期间不发普通按键提示音；故障提示、充满提示在关CHG_EN后再鸣叫，保留故障提示不可静音的要求。

理想许可逻辑已检查：低能力源、来源未确认、扩展未知、电机未禁能、温度/电池异常、电压不足与电源路径未验证均拒绝。仅在所假定前提全部成立时允许手动请求。此为计算/决策模型，尚未实现真实ESP32协议、总输入限流、CHG_EN互锁或供电实测；没有把3 A电源视为已经验收。

### 13.3 VBUS需要可测电压，而不只是有/无

PC2/D3在G431准确封装中支持ADC1_IN8，本轮由普通GPIO存在检测改为VBUS_ADC，球位数量不变。ADC1慢速规则组增加VBUS采样，暂分配DMA2_CH3/ADC1请求，DMA共9/12通道；电流注入组仍保持两ADC、双秩同步采样。实际规则/注入组仲裁、VDDA/VREFINT校准和DMA驱动仍未实现。

可先评估VBUS经100k/47k（0.1%）分压、节点10 nF滤波，连接器5.5 V时节点约1.76 V；这是检测提案，不能代替输入过压保护。未供电反灌/ADC保护仍需按第11节处理。待误差/响应校准后，评估“≥4.8 V稳定1秒才允许请求、<4.6 V持续20 ms停止充电”的门限；USB拔出还要及时撤销许可，具体检测期限按控制安全要求落实。当前阈值是设计起点，不是已保证的准确检测范围。

这些采样只能观察电压，不能证明充电头可供多少电流；总限流仍应覆盖核心和充电两支路。相应功能没有集成进MCU资源探针，旧编译体积不作为新增完整驱动/状态机已装下的证据。

### 13.4 同一低压问题也影响WS2812电平缓冲

只换ESP32 Buck还不够证明整条5V_SYS合格：SN74AHCT1G125原候选推荐VCC最低4.5 V，同样不能在4.4 V系统轨上直接宣称符合规格。可比较工作范围1.8～5.5 V的SN74LV1T125，其输出跟随VCC、支持3.3→5 V翻译，作为较低系统电压下的缓冲候选；准确VCC下输入门限、输出驱动、WS2812版本门限/时序和掉电条件仍须验证，不宣称无条件替换。也可以通过减小MUX/保护路径损耗、确认5V_SYS始终≥4.5 V来保留AHCT；不能仅靠增大电容解决持续压降。

新增依据：[TPS6282x原厂手册](https://www.ti.com/lit/ds/symlink/tps62823.pdf)、[SN74LV1T125原厂手册](https://www.ti.com/lit/ds/symlink/sn74lv1t125.pdf)。候选仅完成电气资料核对，价格/库存和台架结果仍空缺。

## 14. 低于4.5 V输入并覆盖3S母线的宽压Buck补查

2026-10-30直接下载并核对下列原厂手册，范围和额定电流不等于整板低压满载验证。当前5V_SYS→3.3V_ESP架构保留，以下均为候选，尚未替换定案。前述4.175 V为路径预算情景，非实测；本轮以4.0～4.2 V输入下的3.3 V负载/瞬态作为后续验收点。

| 器件 | 推荐VIN | 额定输出电流 | 封装/整流 | 本项目判断 |
| --- | --- | --- | --- | --- |
| AP63203WU-7 | 3.8～32 V | 2 A | TSOT26，同步 | 固定3.3 V，扩展板重点候选；不能用此固定型号输出主板5 V |
| AP63200WU-7 | 3.8～32 V | 2 A | TSOT26，同步 | 可调输出，若2 A预算足够，可分别配置5 V和3.3 V复用同料号 |
| AP63300WU-7 | 3.8～32 V | 3 A | TSOT26，同步 | 可调输出，重点比较两路复用；小封装3 A连续输出仍受散热/电感限制 |
| AP64350SP-13 | 3.8～40 V | 3.5 A | SO-8EP，同步 | 母线耐压余量更大；需要频率设置和外部补偿，面积/外围增加 |
| TPS62933DRLR | 3.8～30 V | 3 A | SOT583，1.6×2.1 mm，同步 | 可调频率、内部补偿，紧凑备选；焊接空间较紧 |
| LMR33630ADDA(R卷带) | 3.8～36 V | 3 A | SO PowerPAD，同步 | 400 kHz版作电气备选，价格未核实 |
| TPS54231 | 3.5～28 V | 2 A | SO PowerPAD，非同步 | 需外部肖特基和补偿；输入下限低，但低压重载不能只按3.5 V下限推断 |
| TPS54331DDA(R卷带) | 3.5～28 V | 3 A | SO PowerPAD，非同步 | 另有普通SOIC版本；需肖特基和补偿，优先级低于上述同步方案 |
| LMR14030 | 4.0～40 V | 3.5 A | HSOIC PowerPAD，非同步 | 低端余量较小，作为40 V备选，不优先用于更低5V_SYS |
| LMR50410 | 4.0～36 V | 1 A | SOT23-6，同步 | 小电流备选，瞬态余量弱于2/3 A方案 |

AP63200/203及AP63300手册低压差章节说明通过跨周期保持高侧导通、低侧短暂刷新自举实现接近100%有效占空比。AP64350也支持该模式。TPS62933和LMR33630可降频扩展占空比，标称最高98%；LMR14030低压差章节约97%。这些均不具备升压能力；最低VIN只代表工作范围，不能认为3.8 V输入可输出5 V，或任意电流都能保持3.3 V。以4.175→3.3 V计算理想占空比约79.0%，具备进一步核查价值，实际仍有开关/电感/布线损耗与瞬态跌落。

TPS54231/TPS54331手册既有自举条件允许短暂100%导通的说明，也有最大可控占空比90%最小/93%典型和应用章节约91%输出上限估算。选这两款时应按应用公式核算高温导通电阻、电感DCR和二极管压降，不能宣传为无条件100%占空比，或把3.5 V直接当作3.3 V满载的可用输入。

耐压必须区分推荐范围和绝对最大值：AP63200/203与AP63300推荐32 V，VIN绝对最大35 V DC、40 V/400 ms；AP64350推荐40 V，绝对最大42 V DC、45 V/400 ms。以上短时数值只属于绝对最大额定，不能据此安排正常浪涌工作点，也不能解释为符合任意浪涌波形。TPS62933推荐30 V/绝对最大32 V，LMR33630与LMR50410为36/38 V，TPS54231/331为28/30 V，LMR14030为40/44 V。

LMR36510虽然推荐最高65 V、绝对最大70 V，但推荐最低4.2 V且只有1 A，无法覆盖4.175 V预算情景，本项目不优先。此前TPS62822/23仅适用于受限的5 V支路，最高5.5 V，不能直接接3S；TPS62133推荐最高17 V，仍可用于受控母线，但不是本轮追求更宽耐压的首选。

本轮建议先核价AP63300WU-7（可调、两路复用）和AP63203WU-7（固定3.3 V扩展板），需要更大母线余量再比较AP64350SP-13；TPS62933和LMR33630保留备选。此排序基于电气适配与外围，不是已经证实的价格排序。搜索服务503、商城搜索无有效商品数据；未取得准确散料数量档人民币报价/实时库存，因此不写未经验证的价格或宣称现货充足。

3S满电12.6 V本身均在上述推荐范围内；能否承受实际过冲还要规定输入钳位电压、波形/能量与温度。降压芯片耐压提升不能提升现有30 V功率MOS和整条母线其他器件的耐压；持续回生仍由制动/保护电路处理。主板3S→5 V与扩展5V_SYS→3.3 V可以用同一可调料号、分别设计电感/分压/电容，不能共用一套未经核算的外围，也不改变扩展板从5V_SYS取电的既定要求。

原厂资料：[AP63200/203](https://www.diodes.com/assets/Datasheets/AP63200-AP63201-AP63203-AP63205.pdf)、[AP63300](https://www.diodes.com/assets/Datasheets/AP63300-AP63301.pdf)、[AP64350](https://www.diodes.com/assets/Datasheets/AP64350.pdf)、[TPS62933](https://www.ti.com/lit/ds/symlink/tps62933.pdf)、[LMR33630](https://www.ti.com/lit/ds/symlink/lmr33630.pdf)、[TPS54231](https://www.ti.com/lit/ds/symlink/tps54231.pdf)、[TPS54331](https://www.ti.com/lit/ds/symlink/tps54331.pdf)、[LMR14030](https://www.ti.com/lit/ds/symlink/lmr14030.pdf)、[LMR50410](https://www.ti.com/lit/ds/symlink/lmr50410.pdf)、[LMR36510](https://www.ti.com/lit/ds/symlink/lmr36510.pdf)。本轮10份PDF归档并记录SHA256，AP63203/AP64350额定表已查看页面确认。

## 15. 制动电阻采购预选历史（2026-11-02；当前选型以第18节为准）

预选为台架打样方案，不是已验证整车BOM：CCO千志CR-L10W-5Ω 5% P，立创C334308，插件48×9.5 mm，四只组成两只串联、两组并联，等效5 Ω±5%，标称额定功率之和40 W。13.8 V时总电流2.76 A、总功率38.09 W、每只9.52 W；按导通门限预算上沿14.29 V及同向-5%阻值角落，总功率42.99 W、每只10.75 W，已经超过各只10 W。因此仅作为受控脉冲/低平均功率测试候选，不能保证持续泄放；需核对准确脉冲曲线、热降额、散热间距、失效和绕线寄生参数，不能把一般过载测试当作可重复制动许可。四只占用尺寸较大，先外接测试支架，不冻结装车空间。单支路开路会使等效阻值增大并削弱泄放。

渠道快照：2026-11-02直接取得立创商品页结构化价格和库存。价格未取得明确数量阶梯，均为网页参考价，非单只成交价；不含运费，不把海外美元价格换算为国内报价。

| 型号/商城商品 | 网页参考单价 | 库存快照 | 预选判断 |
| --- | --- | --- | --- |
| CR-L10W-5Ω 5% P / C334308 | ¥1.2714 | 469 | 台架首选，四只参考物料额约¥5.09，起订/数量档待结算核实 |
| CR-L10W-10Ω 5% P / C334306 | ¥1.0275 | 1559（动态变动） | 便宜备选；两只并联5 Ω但仅20 W标称和，13.8 V全接通时每只19 W，不作为持续泄放方案 |
| VO RX24/110W-4Ω7±1% / C49375359 | ¥84.17 | 2 | 阻值合适，但商品毛重约150 g，成本/体积不适合当前桌面车首选；110 W须按指定散热条件核对 |
| Ohmite HS25 4R7 J / Mouser | ¥72.1279（1只，含13%税，公开索引） | 316（公开索引，非实时确认） | 进口价格高，25 W额定不足以直接覆盖13.8 V全接通约40.5 W；需脉冲曲线，暂不优先 |

此前10 Ω/25 W起算提案没有成为定案；本轮5 Ω网络是更强泄放能力的实验候选，不能推断双电机回生已足够覆盖。后续测量净回生峰值、单次能量和重复热耗散后，再决定是否缩为单只4.7～6.8 Ω功率电阻。制动MOS与连接器至少按实际最高钳位电压、最低等效阻值核算电流，5 Ω负载并不证明原制动电路已经通过。

ICKey已检索具体系列/型号并访问其商城，但未取得有效对应商品价格/库存，不能声称已完成该渠道比价；没有对外发送询价或下单。立创较便宜的参考价足以支持台架候选方向，尚不能证明最终采购成本最低。

来源：[立创5 Ω](https://item.szlcsc.com/312795.html)、[立创10 Ω](https://item.szlcsc.com/312793.html)、[立创110 W铝壳](https://item.szlcsc.com/51887227.html)、[Mouser HS25](https://www.mouser.cn/zh/ProductDetail/Ohmite/HS25-4R7-J?qs=bvCpHSZmQjkZmj3QSjS86w%3D%3D)、[ICKey](https://www.ickey.cn/)。准确商品链接比通用RX24名称更可靠；本轮未取得水泥电阻对应的重复脉冲认证结果，不把额定功率相加当作热验证。

## 16. 平面无感电阻补充预选历史（2026-11-02；当前选型以第18节为准）

用户提供的立创搜索链接未能完整读取，不能声称已看到该会话全部筛选结果；以下为同类关键词定位并直接打开的具体商品。装车方向优先比较单颗RESI TPAN0220F5R60K9（C19707914，5.6 Ω±1%，TO-220，50 W）和TPAN0220F6R80K9（C22446546，6.8 Ω±1%，同系列）。四水泥电阻网络保留为低成本台架备选，不作为装车首选。

直接商品页结构化快照：5.6 Ω参考¥15.08、库存199；6.8 Ω参考¥11.92、库存489。TO-263的TPAN0263F10R0K9（C39142111）参考¥13.23、库存0，两颗并联5 Ω的物料参考¥26.46，但当前无货，不优先。参考价未取得准确起订/阶梯，不是最终散料成交价。

13.8 V时5.6 Ω吸收2.46 A/34.01 W，6.8 Ω为2.03 A/28.01 W。阻值下降可提高瞬时泄放能力，实际双电机回生能量未知，不声明任一已经满足。本轮优先5.6 Ω仅基于单颗实现、成本/体积与中间阻值的权衡。4.7 Ω TPAN0220F4R70K9在厂家资料中存在，但未核实国内立创准确商品价格，不能用其他阻值报价替代。

直接查看商品链接的新版TPAN0220原厂手册页面：无散热器额定2.25 W（旧版资料曾写2.5 W，本轮以准确商品链接新版为准）；50 W条件是加散热器且法兰≤25℃，热阻2.1℃/W，电感≤0.1 µH，本体约10.1×15×4.5 mm、约2.2 g，不含外部散热结构。需导热界面/合适安装及独立散热面，不能仅靠小块PCB铜皮就算50 W。5.6 Ω接通34 W时按内部热阻估算温升约71℃，散热器要求仍显著。手册虽给出脉冲能量/功率图，图的条件和重复应用约束仍须与厂家确认，尚未认可特定制动脉冲；未以50 W标称或短时过载测试当作本车验收。

商品：[5.6 Ω](https://item.szlcsc.com/21015541.html)、[6.8 Ω](https://item.szlcsc.com/24098987.html)、[TO-263 10 Ω](https://item.szlcsc.com/40868061.html)。对应TPAN0220手册：[原厂PDF](https://atta.szlcsc.com/upload/public/pdf/source/20250225/3BE266C6036DE3F643EC29FEF7C979D5.pdf)，额定参数及脉冲图已查看页面，尚无样机验证。

## 17. TO-220与TO-247具体型号比较历史（2026-11-02；当前选型以第18节为准）

直接复查立创商品：TO-220的TPAN0220F5R60K9（5.6 Ω±1%、50 W、C19707914）参考¥15.08/库存199，TPAN0220F6R80K9（6.8 Ω±1%、50 W、C22446546）参考¥11.92/库存489。TO-247的Ohmite AP101 5R F（5 Ω±1%、100 W、C3371826）参考¥10.65但库存0，缺货页面价不能认为可按此价即时购买。ICKey仍未取得有效对应型号报价。截图RTP50/RTP100缺少品牌、准确阻值后缀、手册和实际报价，不能视为已确认的可采购替代品。

TPAN0220：本体10.1×15×4.5 mm，热阻2.1℃/W，50 W条件为法兰≤25℃且有散热器，裸放2.25 W；已看过脉冲曲线，应用条件仍待确认。AP101：TO-247本体大致15.75×20.7×4.95 mm（以准确图纸公差为准），100 W条件是壳温25℃且安装散热器，25℃自由空气额定3.5 W；准确商品手册未直接列出内部热阻或可供本车使用的重复脉冲能量曲线，不能把100 W或1.5倍5秒短时过载测试当作反复刹车验收。两者都便于螺丝安装独立散热器。

13.8 V时AP101 5 Ω约2.76 A/38.09 W，TPAN 5.6 Ω约2.46 A/34.01 W；此功率差源于阻值，不是封装导致。相同能量下二者平均热量相同。TO-247提供更大安装面、较高带散热器额定及较高裸放额定，但还不能证明具体刹车脉冲优势；选型应同时看能量与重复频率。

预选结论：当前有货且准确资料可追溯的TPAN0220F5R60K9继续为现阶段第一候选，AP101 5R F进入TO-247待供货备选，不因缺货参考价较低而改变当前采购优先级。若取得价格相近、有明确脉冲能力的TO-247 4.7～5.6 Ω现货，可重新排序；不固定必须TO-220。当前既不冻结散热器，也不宣称必须持续消耗34～38 W；需先补车重/速度/轮转动惯量与实际泄放波形。

来源：[AP101准确立创商品](https://item.szlcsc.com/3937121.html)、[商品关联原厂手册](https://atta.szlcsc.com/upload/public/pdf/source/20210606/6D8CC6B67B385B7F47A9AF9CF2F81DE9.pdf)、[Ohmite原厂说明](https://www.ohmite.com/acl-ap101/)。价格为公开页面参考字段，数量档未确认，库存为查询快照，尚未下单。

## 18. 泄放电阻已选定：TPAN0263F6R80K9

2026-11-02，用户明确确认采用RESI（开步睿思）TPAN0263F6R80K9，立创编号C38486200，6.8 Ω±1%，50 W，TO-263平面无感功率电阻。此决定取代第15～17节的水泥电阻网络、TO-220和TO-247预选方向；TPAN0263F3R30K9仅为历史比较，不作为并列当前选型。型号/参数由用户商品截图及明确确认记录，当前不以先前其他系列的热阻或裸放功率替代该准确型号参数。

来源：[用户确认的准确商品](https://item.szlcsc.com/40209620.html)。此前截图单只¥19.43，仅为截图报价，不声明当前实时价格/库存或已购买。两电机仍共用一条制动支路，不改变硬件比较器自主控制方向。

13.8 V完全接通时电流约2.029 A、功率28.006 W；按暂定门限包络上沿14.29 V及阻值下偏1%（6.732 Ω）计算约2.123 A、30.333 W，供制动MOS/走线预算。该结果既不是实际回生电流，也不证明已能钳住双电机全部回生。额定50 W具有散热条件，不能视为普通PCB上可持续消耗50 W。按实际工况核算单次E=∫V_R²/R·dt及重复平均功率，继续核对准确TPAN0263手册的脉冲限制、底部焊盘导热、焊接空洞和温升；丝印面辅助散热不替代底部主导热路径。当前没有固定散热器尺寸，也没有认定必须持续28 W耗散。BMS断开、满电、双电机同回生、控制冷启动和故障条件仍待验证。
