Sandman6z/BalanceCar-DualFOC/结构/结构方案.md

# 结构方案

更新：2026-11-02。首版目标为紧凑的桌面双轮原地平衡车，结构由用户自制3D打印。没有机械CAD、加工图、实物尺寸或整车验证结果。

## 1. 已确认布局

- 用户3D打印连接两轮并固定电池的底座，不采购成品车底盘；三节平头18650电气串联、机械横向并排，规划在主板下方。
- 左右各一颗2204云台电机，两轮同轴；完整电机型号、轴/法兰尺寸、轮径与整车重量仍未知。
- 板卡为一块主PCB、两块相同AS5047P编码器板、一块可选ESP32扩展板。基础平衡不依赖扩展板。
- 0.96英寸SSD1315 OLED、四个按键、蓝绿LED、四颗WS2812、一颗FUET-8530-3.6V蜂鸣器需要可见/可操作/可发声位置。
- MCU要求BGA，球数和PCB尺寸没有硬性上限。当前暂定STM32G431RBI6，UFBGA64、5×5 mm、0.5 mm球距；预留扇出与返修空间，板孔以实际布局和结构配合确定。2026-10-30引脚方案用满51个功能IO（另保留NRST），当前按无外部晶振规划；2026-11-02单nFAULT输入提案可释放PD2，旧引脚表尚未更新，若增加功能或晶振仍需重新核查。

## 2. 安装建议

一体框架承担电机轴线、电池和板卡定位；PCB用独立支柱安装，不承担电机轴/轴承或编码器磁铁气隙定位。保证轮轴同轴、左右驱动方向一致，电芯可靠固定并保留正负极绝缘、防磨和拆取空间。

使用平头兼容的电池接点/电池座，按电芯实际直径、长度及公差建模；不能只按“18×65 mm”冻结夹具，也不能由平头推断是否有保护板。接点压降与允许电流需配合硬件预算。循环寿命不作选型要求，不影响对实际尺寸/电流的核查。

轮径60 mm、质量0.5 kg仅是此前扭矩情景占位，不是用户要求或已定尺寸；首版没有速度、越坎、爬坡/急加速目标，不将旧V2.0愿景当作验收指标。

IMU靠近稳定刚性基准、远离功率电感/蜂鸣器/机械应力点；安装姿态可重复，坐标轴方向标清。编码器磁铁规格、极性、轴心偏差、气隙按AS5047P资料及样件验证，不凭经验冻结尺寸。

蜂鸣器声孔不得被底座、胶带或元件遮挡，验证装壳和电机噪声下的普通/低电量/故障提示；磁场/振动不能干扰IMU或编码器。FUET资料高度与渠道存在差异，按准确供货版本实物确认。

回生电阻可预留外置位置，避开电芯、塑料、IMU和触碰区，按脉冲能量/重复热耗散安排散热与绝缘。当前电阻为已定TPAN0263F6R80K9（6.8 Ω、TO-263、条件额定50 W），底部法兰/焊盘为主要导热路径；额定50 W不意味着裸板可持续耗散50 W。

ESP32天线按官方净空要求，避免电池、铜面、紧固件遮挡。BTB实际合高与配对未确认，不能将公/母座H值相加直接定空间。保留USB、SWD、NRST、按键、电池、主板及编码器拆装维护空间。

## 3. 标定与装配验收

需要标定/核查：电流零偏，电机相序/极对数，编码器机械角与电角零点，左右轮正方向，磁铁轴心和气隙，IMU坐标/静止零偏，车身直立零点。

首次标定可以按OLED提示固定车身、保持静止并人工确认；电机对齐动作单独提示且受限，不由USB插入直接触发。先用固定支架进行低能量单/双电机验证，再装轮尝试平衡。

装配检查包括：轮子自由转动无干涉，电机/编码器安装牢固，电芯固定/绝缘，板卡不受装配应力，线束应力释放与极性，散热和声孔，USB/调试口可接近。摔倒、扶正恢复、外力转轮回生、重复制动和电源插拔测试按整机/软硬件文档执行；目前均未验证。

## 4. 待补尺寸与文件

实际电机轴/固定孔/法兰、轮径和轮胎，电芯实物尺寸，整车质量/重心高度，编码器磁铁与安装气隙，主板外形和孔位，BTB合高与天线净空，电阻散热位置、OLED及按键面板。完成后在本文件旁放结构源文件与导出图，不另建多层文档目录。

依据：[AS5047P厂家资料](https://www.infineon.com/assets/row/public/documents/30/49/infineon-as5047p-datasheet-en.pdf)、[ESP32-S3模组手册](https://documentation.espressif.com/esp32-s3-wroom-1_wroom-1u_datasheet_en.pdf)。

## 5. 本轮硬件复核对结构的要求（2026-10-30）

2026-11-02取消外部INL锁存必选要求，不再为其专门增加逻辑器件空间；LDO同时比较原SOT23-5候选与带散热焊盘封装，预留散热铜；ME6211/ME6217的准确M5热参数缺项，不能仅按旧300 mW数据排除，也不先锁死布局。主板约0.5 W级LDO热耗散、已定6.8 Ω制动电阻在13.8 V完全接通时约28 W瞬时功耗（不等于持续散热要求）都需要按真实安装与重复负载验证，不能贴靠电芯或打印塑料。

编码器厂家参考磁铁为N35H、直径8 mm/厚3 mm，磁场范围约35～70 mT；这是资料参考，不是已选磁铁尺寸或允许直接冻结的气隙。设计轴心/高度调整余量并安排DIAAGC诊断验收。电池/充电/BMS/主控若各自使用NTC，传感器节点不可未经电路核查共接，需预留安装与走线空间。

BTB准确配对合高、电机轴/轮轴强度、轮胎及电芯座尺寸仍无实物/CAD，未做几何或强度验证。
