Sandman6z/BalanceCar-DualFOC/软件/MCU验证/pinout.csv

pin | ball | signal | role
PA8 | E6 | TIM1_CH1 | MOTOR_L_U
PA9 | D7 | TIM1_CH2 | MOTOR_L_V
PA10 | D6 | TIM1_CH3 | MOTOR_L_W
PC6 | E8 | TIM8_CH1 | MOTOR_R_U
PC7 | E7 | TIM8_CH2 | MOTOR_R_V
PC8 | F6 | TIM8_CH3 | MOTOR_R_W
PA0 | F2 | ADC1_IN1 | CURRENT_L_A
PA1 | E3 | ADC2_IN2 | CURRENT_L_B
PA2 | F3 | ADC1_IN3 | CURRENT_R_A
PA6 | G3 | ADC2_IN3 | CURRENT_R_B
PA3 | H2 | ADC1_IN4 | VMOTOR_SENSE
PF0 | E1 | ADC1_IN10 | VBAT_SENSE
PB0 | E5 | ADC1_IN15 | BATTERY_NTC
PB2 | H4 | ADC2_IN12 | POWER_NTC
PA5 | E4 | SPI1_SCK | ENC_SCK
PB4 | C4 | SPI1_MISO | ENC_MISO
PA7 | H3 | SPI1_MOSI | ENC_MOSI
PA4 | D4 | GPIO_Output | ENC_L_CS
PB1 | F5 | GPIO_Output | ENC_R_CS
PC10 | C5 | SPI3_SCK | IMU_DRV_SCK
PC11 | B6 | SPI3_MISO | IMU_DRV_MISO
PC12 | A6 | SPI3_MOSI | IMU_DRV_MOSI
PC4 | D5 | GPIO_Output | IMU_CS
PB3 | A5 | GPIO_Output | DRV_L_CS
PB15 | F7 | GPIO_Output | DRV_R_CS
PC5 | F4 | GPIO_Input | IMU_DRDY_EXTI5
PA15 | A7 | I2C1_SCL | OLED_SCL
PB9 | A2 | I2C1_SDA | OLED_SDA
PB10 | H6 | USART3_TX | ESP_TX
PB11 | H7 | USART3_RX | ESP_RX
PA11 | C8 | USB_DM | USB_DM
PA12 | B8 | USB_DP | USB_DP
PA13 | C7 | SYS_JTMS-SWDIO | SWDIO
PA14 | C6 | SYS_JTCK-SWCLK | SWCLK
PG10 | D2 | RESET | NRST
PB6 | A4 | TIM4_CH1 | WS2812
PB5 | B4 | TIM17_CH1 | BUZZER
PB7 | A3 | GPIO_Output | GREEN_LED
PB13 | G6 | GPIO_Output | DRV_L_ENABLE
PB14 | F8 | GPIO_Output | DRV_R_ENABLE
PB12 | G8 | TIM1_BKIN | COMMON_NFAULT
PD2 | B5 | TIM8_BKIN | COMMON_NFAULT
PC13 | B1 | GPIO_Input | K1
PC14 | C1 | GPIO_Input | K2
PC15 | D1 | GPIO_Input | POWER_KEY
PC0 | E2 | GPIO_Output | CORE_HOLD
PC1 | C3 | GPIO_Output | MOTOR_POWER_EN
PB8 | B3 | GPIO_Output | CHARGE_EN
PC2 | D3 | ADC1_IN8 | VBUS_ADC
PC3 | G1 | GPIO_Input | CHARGE_LED_LEVEL_SHIFTED
PF1 | F1 | GPIO_Output | PWM_ARM_CLOCK
PC9 | D8 | GPIO_Input | BRAKE_ACTIVE
