Sandman6z/BalanceCar-DualFOC/(commit log)

2026-10-22 docs: document current Balance Car design by module
2026-10-22 docs: sync peripheral decisions and verified 3S charging comparison
2026-10-23 docs: confirm unbalanced first revision and TPS563201 buck choice
2026-10-23 docs: define mainboard 5V and separate ESP32 3.3V supplies
2026-10-28 docs: sync current design, STM32 BGA and LVGL requirements
2026-10-29 docs: select STM32G431RBI6 and revise compact LVGL plan
2026-10-30 verify: check G431 BGA pin plan and build dual FOC LVGL USB resource probe
    [pinout.csv]
2026-10-30 verify: audit power charging drive faults and regenerative braking
    [pinout.csv]
2026-10-30 verify: refine ESP supply candidates VBUS sensing and charge power gating
    [pinout.csv]
2026-10-30 docs: verify wide-input buck candidates for 3S and low 5V rail
2026-11-02 docs: preselect budget brake resistor network with channel quotes
2026-11-02 docs: shortlist compact RESI planar brake resistors
2026-11-02 docs: compare stocked TO220 and TO247 brake resistor candidates
2026-11-02 docs: confirm TPAN0263F6R80K9 brake resistor selection
2026-11-02 docs: clarify dual-driver startup and shutdown safety timing
2026-11-02 docs: simplify shared driver fault handling per user decision
